KaiPereira/MIDI-Keypad/PCB/production/bom.csv

Designator | Footprint | Quantity | Value | LCSC Part #
D1, D2, D3 | LED_SK6812MINI-E_3.2x2.8mm_P1.5mm_ReverseMount | 3 | SK6812MINI-E
J1 | Capacitive Keys | 1 | Capacitive Touch Buttons
RV1, RV2 | Potentiometer_Bourns_PTA1543_Single_Slide | 2 | Slider
SW1, SW2, SW3 | Kailh Choc Low-Profile Switches | 3 | SW_Push
SW4 | RotaryEncoder_Alps_EC11E-Switch_Vertical_H20mm | 1 | RotaryEncoder_Switch_MP
U1 | Waveshare ESP32-S3-Zero | 1 | Waveshare ESP32-S3-ZERO
