KaiPereira/MIDI-Keypad/PCB/models/Bourns Slide Potentiometers/PTA1543.STEP

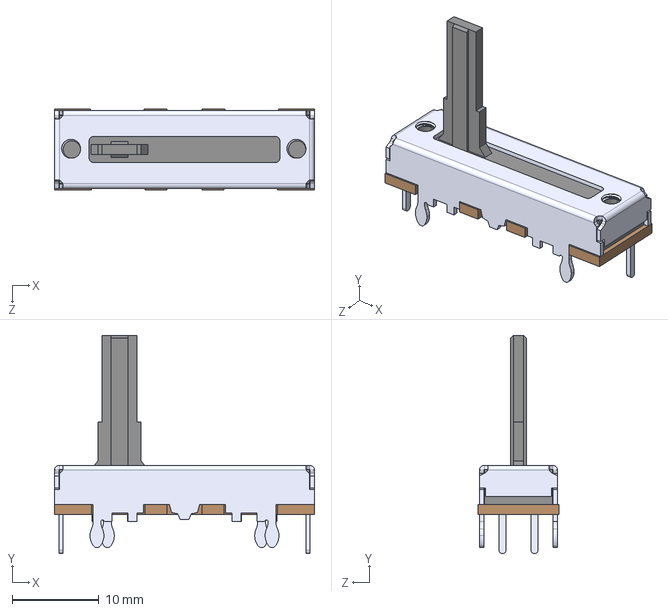
[picture p42: CAD file, 2026-10-13]
PCB/models/Bourns Slide Potentiometers/PTA1543.STEP
30.0 x 25.2 x 9.40 mm
