KaiPereira/MIDI-Keypad/PCB/models/Waveshare ESP32-S3_Zero.step

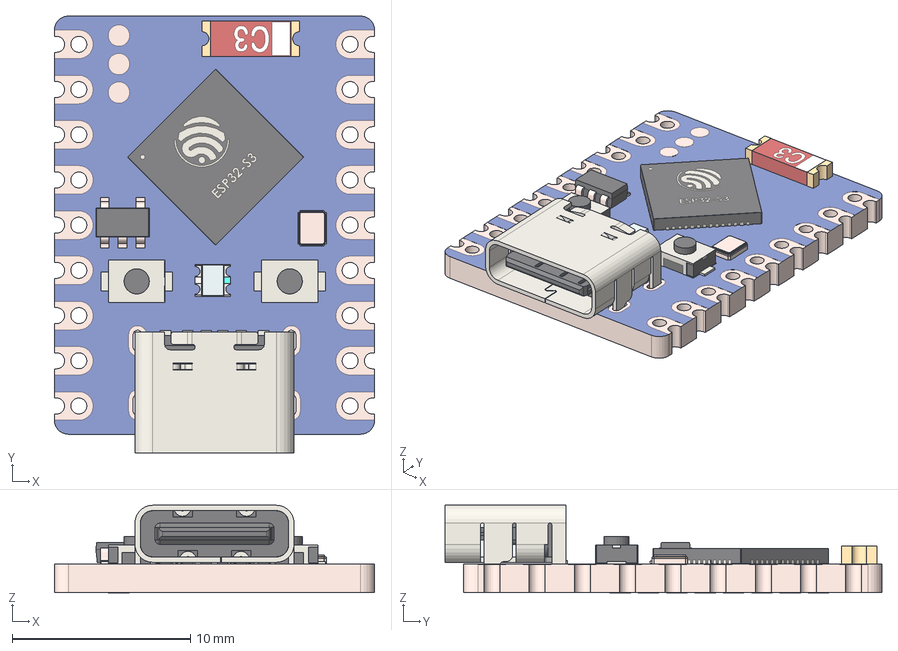
[picture p43: CAD file, 2026-10-13]
PCB/models/Waveshare ESP32-S3_Zero.step
18.0 x 24.6 x 4.92 mm
