KaiPereira/MIDI-Keypad/PCB/models/Bourns Slide Potentiometers/pta6043.stp

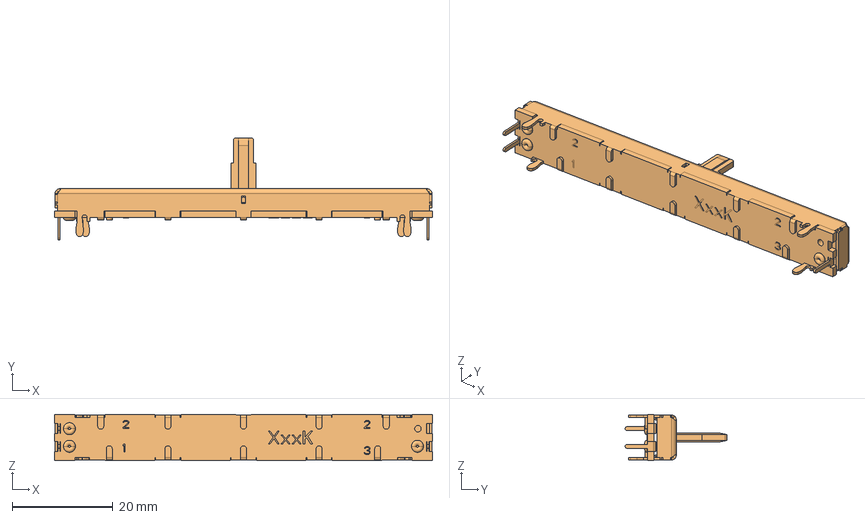
[picture p44: CAD file, 2026-10-13]
PCB/models/Bourns Slide Potentiometers/pta6043.stp
75.2 x 20.2 x 9.20 mm
