KaiPereira/MIDI-Keypad/PCB/models/Bourns Slide Potentiometers/PTA3043.stp

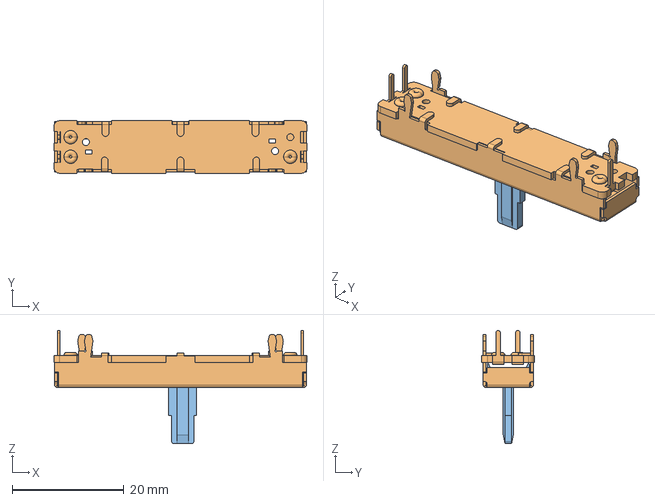
[picture p45: CAD file, 2026-10-13]
PCB/models/Bourns Slide Potentiometers/PTA3043.stp
45.2 x 9.40 x 20.2 mm
