KaiPereira/MIDI-Keypad/PCB/models/Bourns Slide Potentiometers/PTA2043.stp

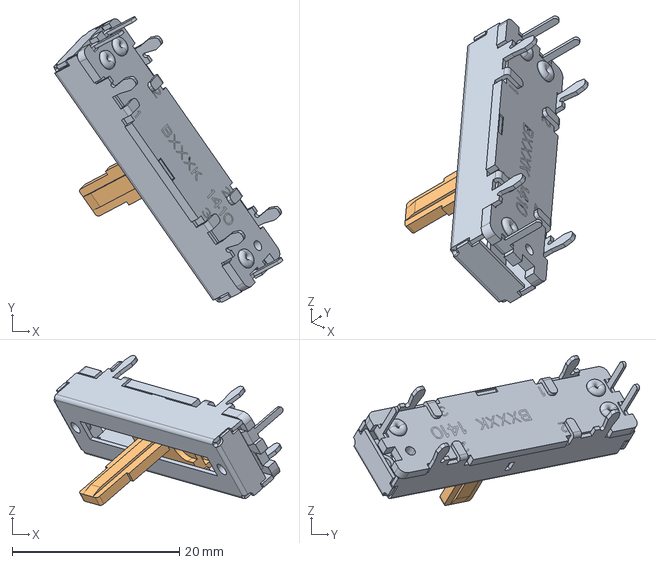
[picture p46: CAD file, 2026-10-13]
PCB/models/Bourns Slide Potentiometers/PTA2043.stp
27.4 x 34.2 x 18.0 mm
