KaiPereira/MIDI-Keypad/PCB/MIDI-keypad.kicad_pcb

## KiCad design PCB/MIDI-keypad.kicad_pcb (2026-10-13)

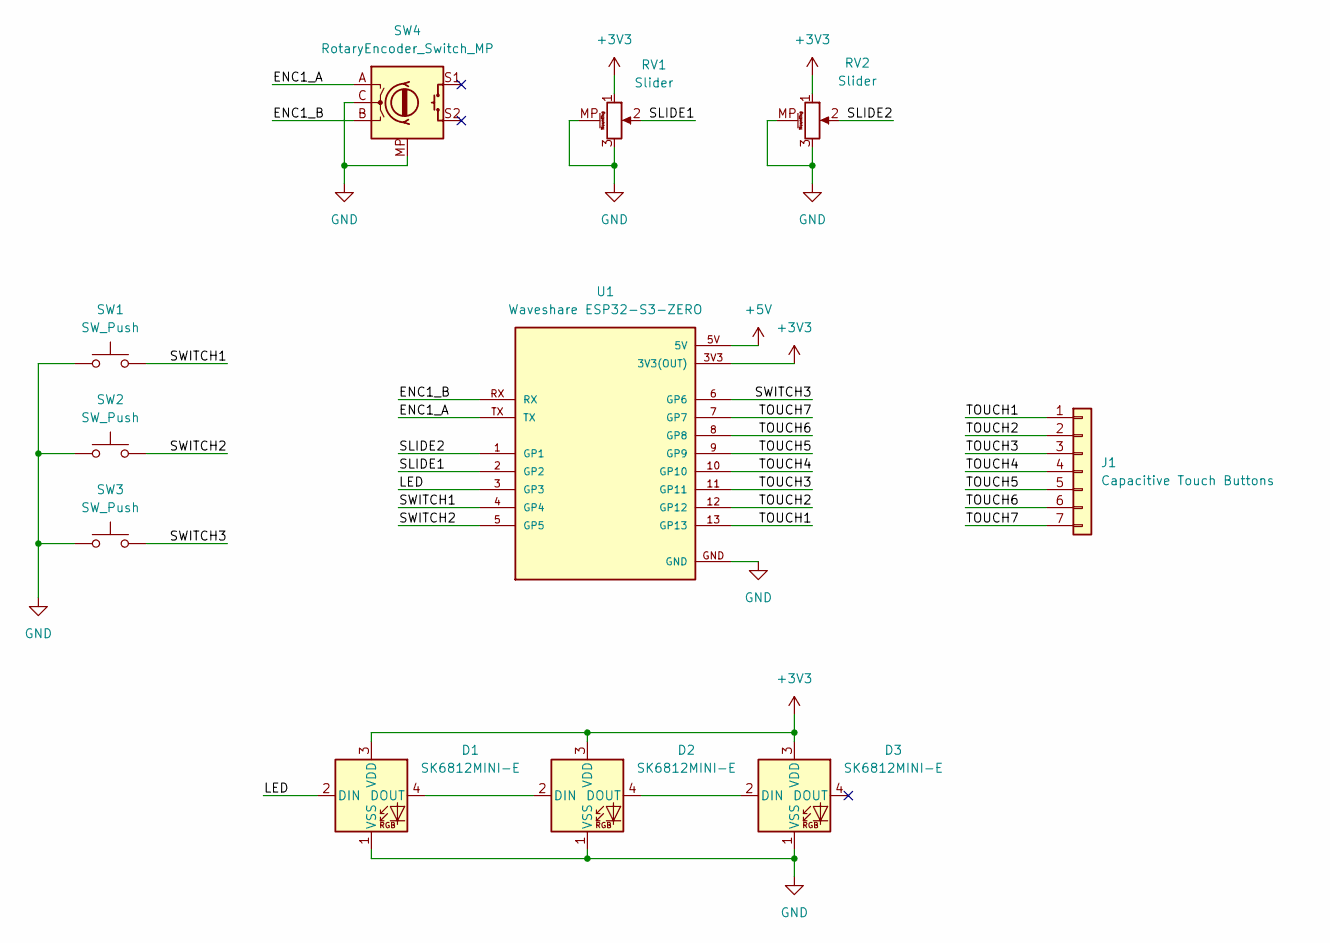
[picture p47: schematic MIDI-keypad.kicad_sch]

Parts:
D1, D2, D3: SK6812MINI-E; LED_SK6812MINI-E_3.2x2.8mm_P1.5mm_ReverseMount
J1: Capacitive Touch Buttons; Capacitive Keys
RV1, RV2: Slider; Potentiometer_Bourns_PTA1543_Single_Slide
SW1, SW2, SW3: SW_Push; Kailh Choc Low-Profile Switches
SW4: RotaryEncoder_Switch_MP; RotaryEncoder_Alps_EC11E-Switch_Vertical_H20mm
U1: Waveshare ESP32-S3-ZERO; Waveshare ESP32-S3-Zero; PARTREV NA

Connections:
+3V3: D1.3 (VDD), D2.3 (VDD), D3.3 (VDD), RV1.1, RV2.1, U1.3V3 (3V3(OUT))
+5V: U1.5V
/ENC1_A: SW4.A, U1.TX
/ENC1_B: SW4.B, U1.RX
/LED: D1.2 (DIN), U1.3 (GP3)
/SLIDE1: RV1.2, U1.2 (GP2)
/SLIDE2: RV2.2, U1.1 (GP1)
/SWITCH1: SW1.2, U1.4 (GP4)
/SWITCH2: SW2.2, U1.5 (GP5)
/SWITCH3: SW3.2, U1.6 (GP6)
/TOUCH1: J1.1, U1.13 (GP13)
/TOUCH2: J1.2, U1.12 (GP12)
/TOUCH3: J1.3, U1.11 (GP11)
/TOUCH4: J1.4, U1.10 (GP10)
/TOUCH5: J1.5, U1.9 (GP9)
/TOUCH6: J1.6, U1.8 (GP8)
/TOUCH7: J1.7, U1.7 (GP7)
GND: D1.1 (VSS), D2.1 (VSS), D3.1 (VSS), RV1.3, RV1.MP (MountPin), RV2.3, RV2.MP (MountPin), SW1.1, SW2.1, SW3.1, SW4.C, SW4.MP, U1.GND
unnamed: D1.4 (DOUT), D2.2 (DIN)
unnamed: D2.4 (DOUT), D3.2 (DIN)

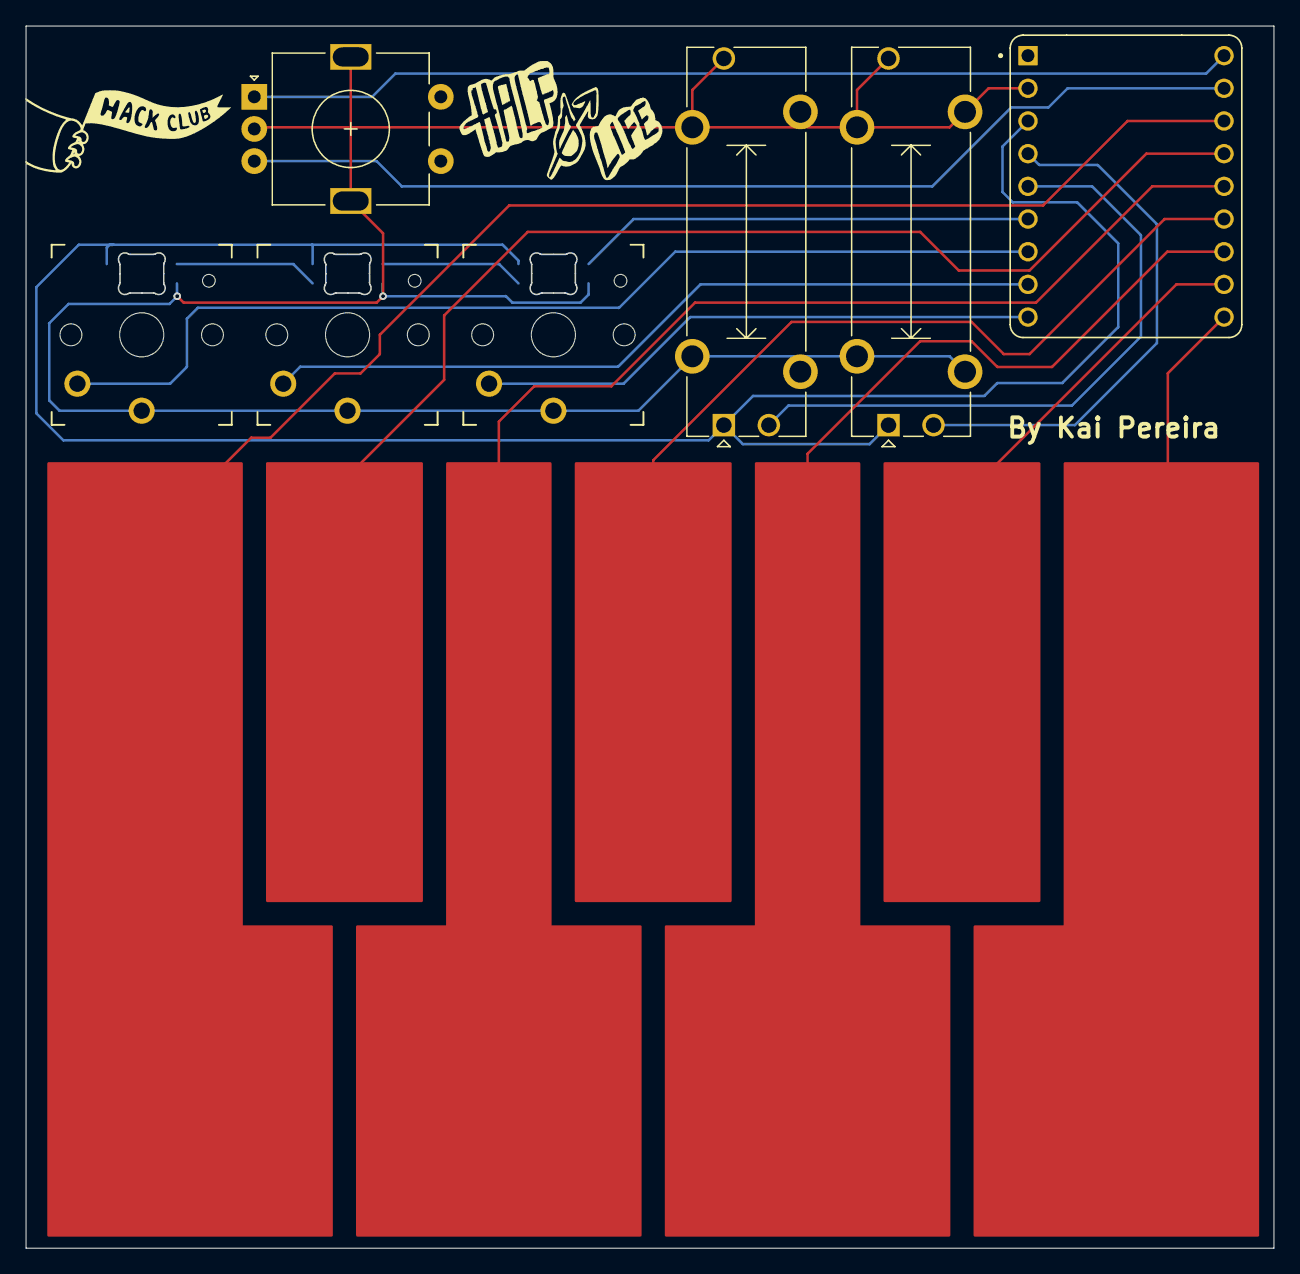
[picture p48: board MIDI-keypad.kicad_pcb from above]

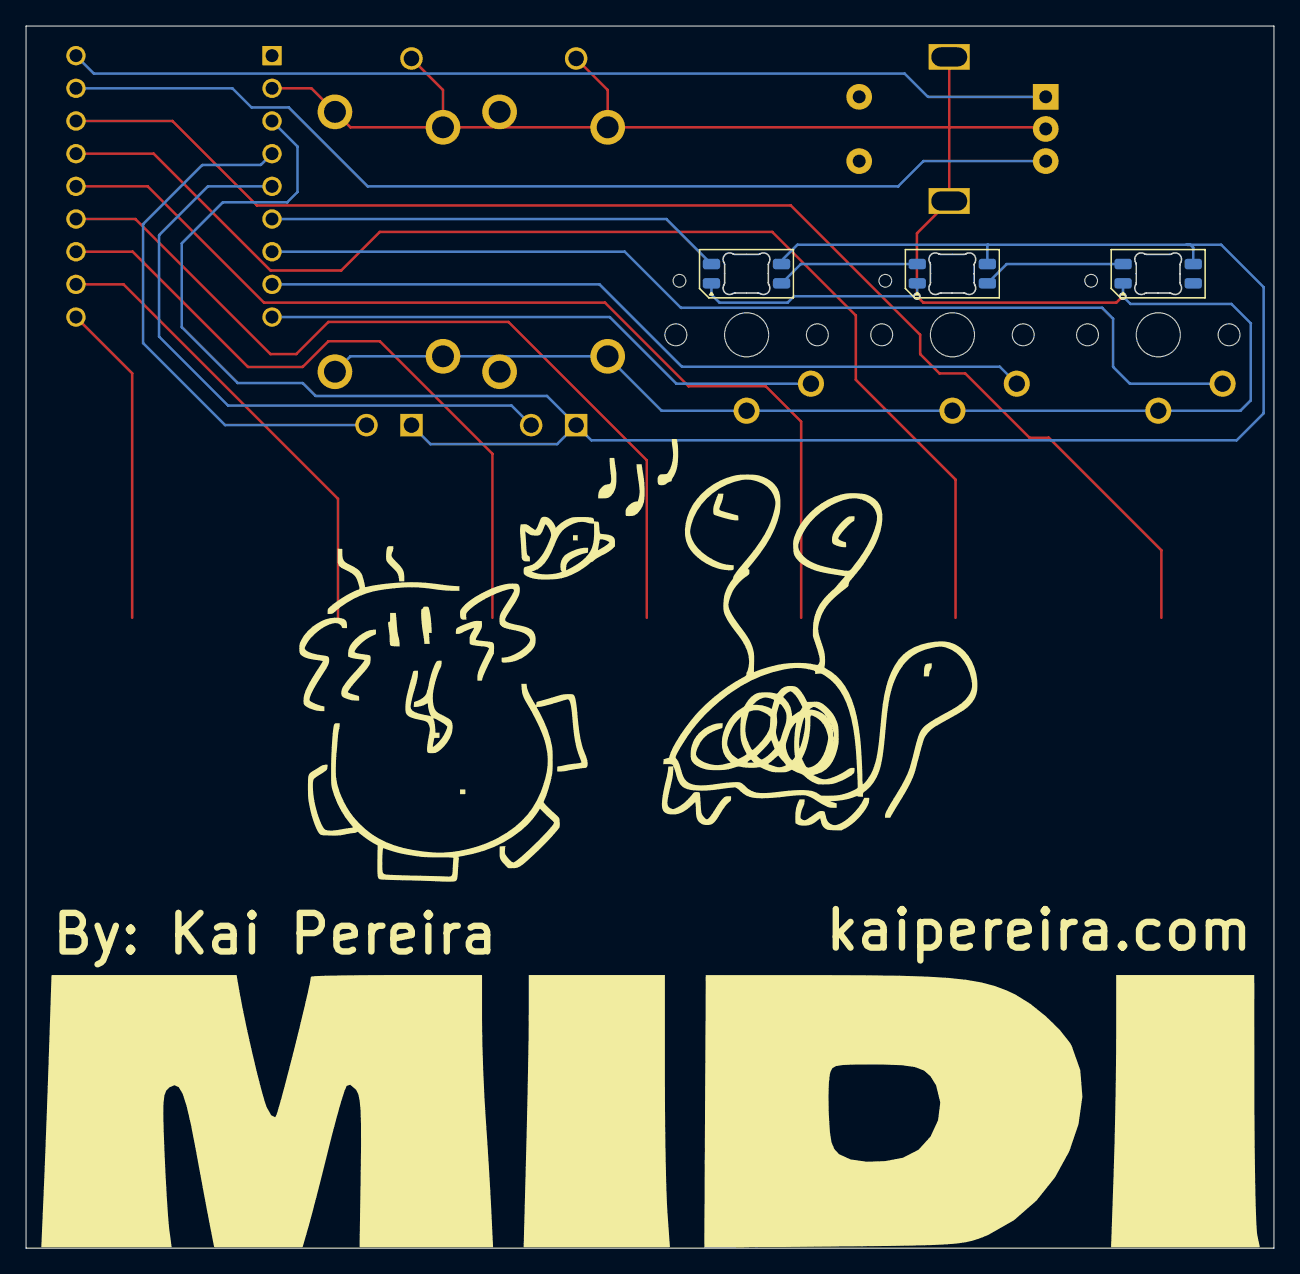
[picture p49: board MIDI-keypad.kicad_pcb from below]

Board: 2 copper layers, 97.0 x 95.0 mm, 11 parts (3 on the bottom side), 19 nets.
